smit2400/Solar_Charger/hardware/Solar_Charge_Controller_BOM.csv

Item | References | Qty | Value | Footprint
1 | C1 | 1 | 100UF 50V | CP_Radial_D5.0mm_P2.50mm
2 | C2, C3, C7, C8, C10 | 5 | 100nF | 1206
3 | C4, C9 | 2 | 10UF 50V | CP_Radial_D5.0mm_P2.50mm
4 | C5 | 1 | 10nF | 1206
5 | C6 | 1 | 220nF | 1206
6 | D1, D3, D5 | 3 | PH4148 | 1210
7 | D2, D6 | 2 | 1N4007 | 1210
8 | J1 | 1 | 01x05 | 1X05
9 | J2, J3, J4, J5, J6, J7 | 6 | 01x02 | TE_282837-2
10 | JM1 | 1 | JMP | 1206
11 | JM2, JM3, JM4, JM5, JM6, JM7, JM8, JM9, JM10 | 9 | JMP | DIODE-1N4001
12 | L1, L2, L3 | 3 | LED | LED_5MM
13 | M1, M2, M3 | 3 | TK40E06N1 | TO220V
14 | Q1, Q5 | 2 | MMBT3906 | SOT23-3
15 | Q2, Q4, Q6 | 3 | MMBT3904 | SOT23-3
16 | R1 | 1 | 26KΩ | 1206
17 | R2, R21 | 2 | 1KΩ | 1206
18 | R3, R22, R25, R31 | 4 | 100KΩ | 1206
19 | R4 | 1 | 35KΩ | 1206
20 | R5, R28 | 2 | 100Ω | 1206
21 | R6, R7, R26, R29, R30, R32 | 6 | 10KΩ | 1206
22 | R8, R27 | 2 | 3.3KΩ | 1206
23 | R9, R12 | 2 | 17KΩ | 1206
24 | R10, R16, R20, R40 | 4 | 2KΩ | 1206
25 | R13 | 1 | 21KΩ | 1206
26 | R15 | 1 | 32KΩ | 1206
27 | R33 | 1 | 46KΩ | 1206
28 | R34 | 1 | 15KΩ | 1206
29 | S1 | 1 | RST switch | TACTILE_SWITCH_PTH_6.0MM
30 | U1 | 1 | 78l05 | SOT89R
31 | U2 | 1 | PIC16F676-I/SL | SOIC127P600X175-14N
32 | Z1, Z3 | 2 | 1N4742A | 1210
33 | Z2 | 1 | 1N4742A | DIODE-1N4001
