smit2400/Solar_Charger/hardware/Solar_Charge_Controller.kicad_pcb

## KiCad design hardware/Solar_Charge_Controller.kicad_pcb (2026-11-07)

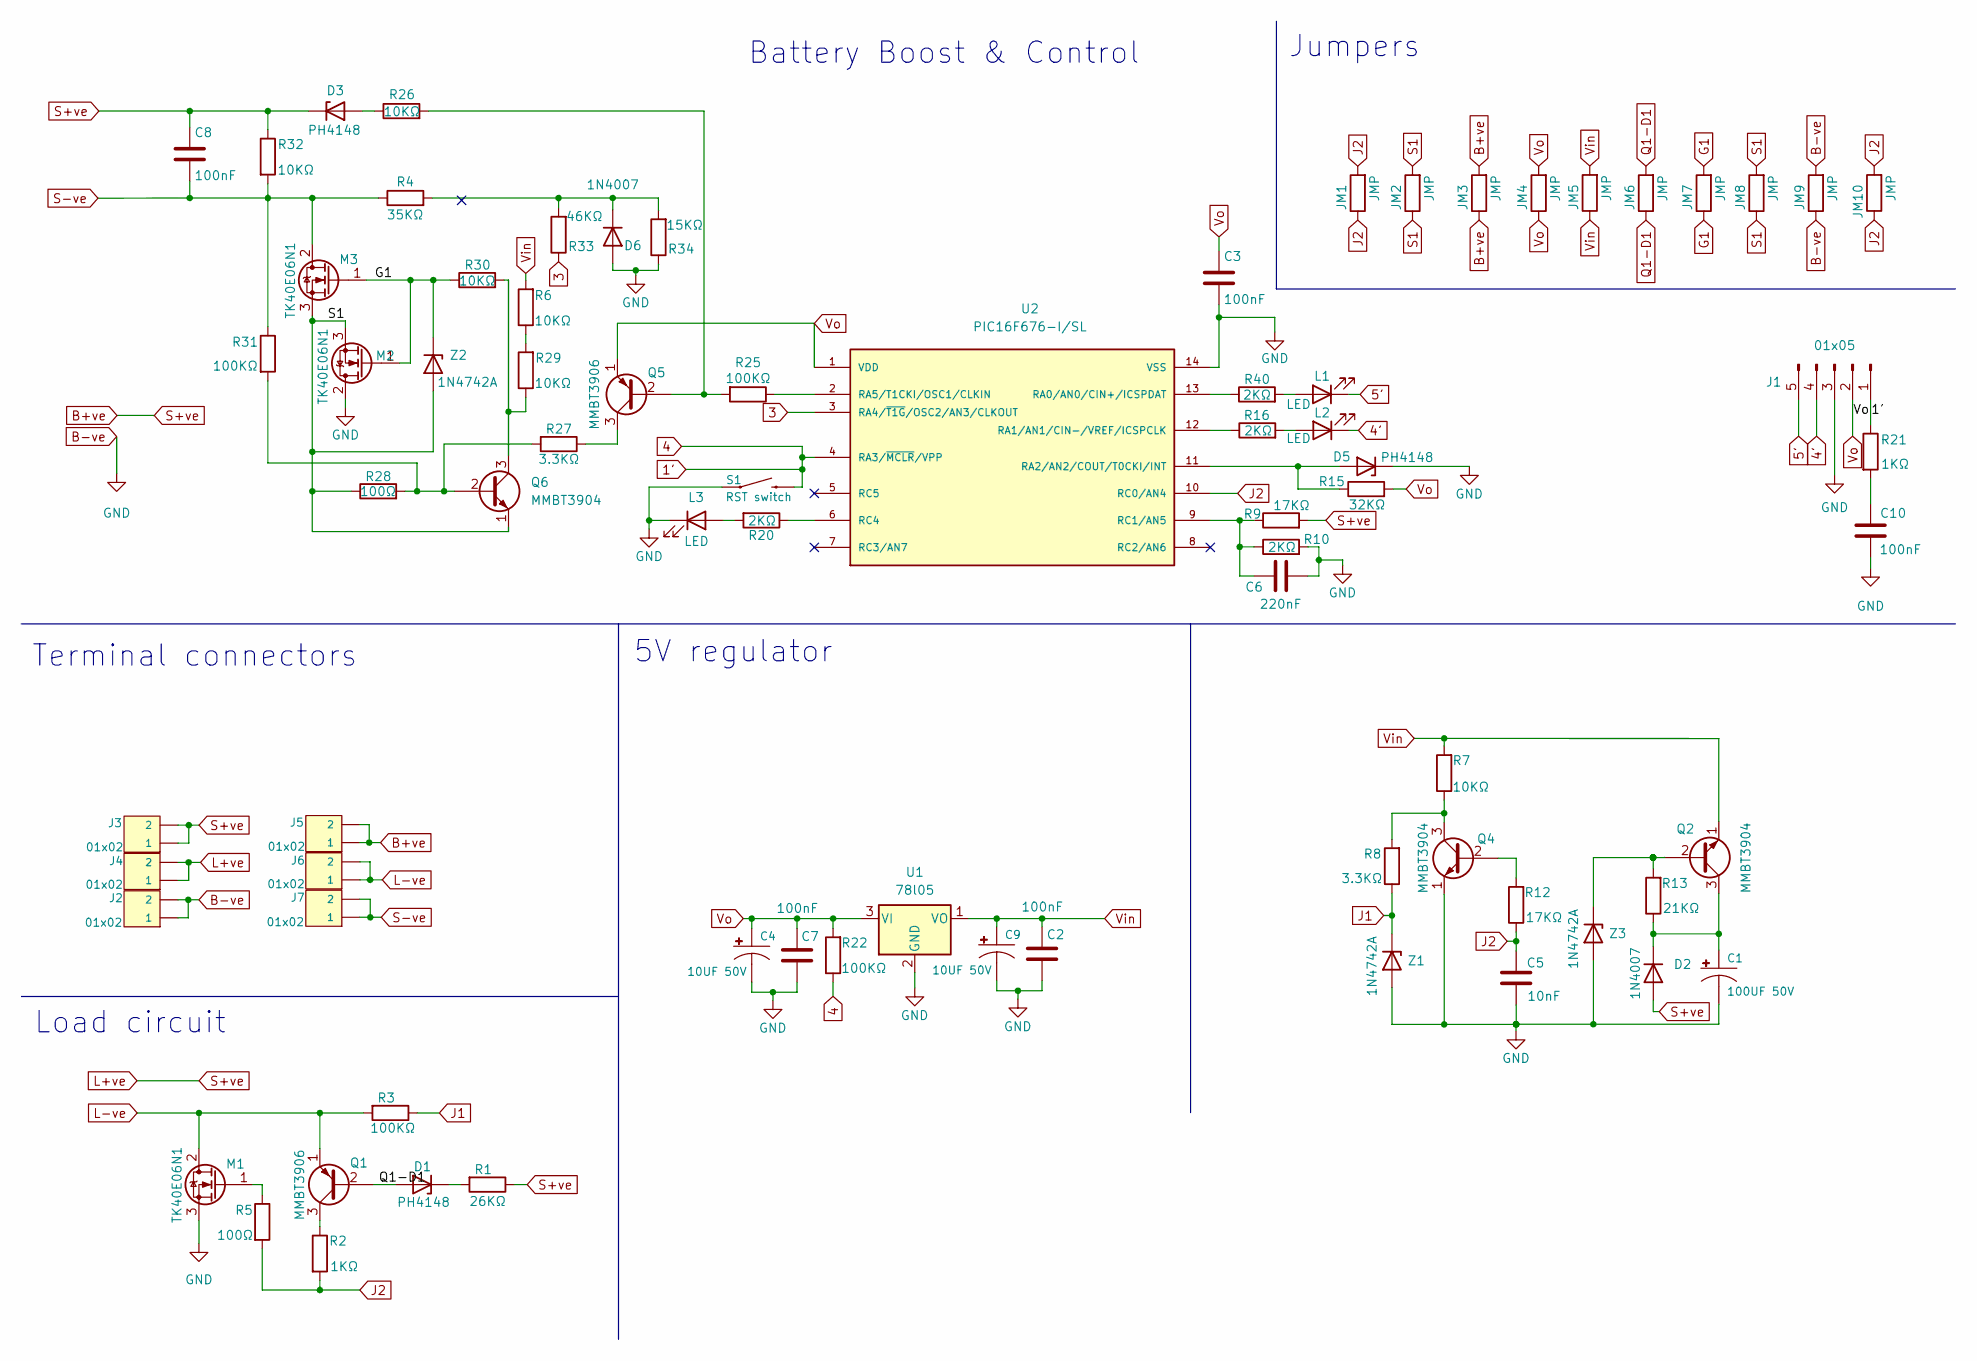
[picture p2: schematic Solar_Charge_Controller.kicad_sch]

Parts:
C1: 100UF 50V; CP_Radial_D5.0mm_P2.50mm
C2, C3, C7, C8, C10: 100nF; 1206
C4, C9: 10UF 50V; CP_Radial_D5.0mm_P2.50mm
C5: 10nF; 1206
C6: 220nF; 1206
D1, D3, D5: PH4148; 1210
D2, D6: 1N4007; 1210
J1: 01x05; 1X05
J2, J3, J4, J5, J6, J7: 01x02; TE_282837-2
JM1: JMP; 1206
JM2, JM3, JM4, JM5, JM6, JM7, JM8, JM9, JM10: JMP; DIODE-1N4001
L1, L2, L3: LED; LED_5MM
M1, M2, M3: TK40E06N1; TO220V
Q1, Q5: MMBT3906; SOT23-3
Q2, Q4, Q6: MMBT3904; SOT23-3
R1: 26KΩ; 1206
R2, R21: 1KΩ; 1206
R3, R22, R25, R31: 100KΩ; 1206
R4: 35KΩ; 1206
R5, R28: 100Ω; 1206
R6, R7, R26, R29, R30, R32: 10KΩ; 1206
R8, R27: 3.3KΩ; 1206
R9, R12: 17KΩ; 1206
R10, R16, R20, R40: 2KΩ; 1206
R13: 21KΩ; 1206
R15: 32KΩ; 1206
R33: 46KΩ; 1206
R34: 15KΩ; 1206
S1: RST switch; TACTILE_SWITCH_PTH_6.0MM
U1: 78l05; SOT89R
U2: PIC16F676-I/SL; SOIC127P600X175-14N
Z1, Z3: 1N4742A; 1210
Z2: 1N4742A; DIODE-1N4001

Connections:
1': J1.1, R21.1, R22.1, S1.3 (2), U2.4 (RA3/~MCLR/VPP)
3: R33.1, U2.3 (RA4/~T1G/OSC2/AN3/CLKOUT)
4': J1.4, L2.1 (K)
5': J1.5, L1.1 (K)
B+ve: C8.1, D2.2 (A), D3.1 (K), J3.1, J3.2, J4.1, J4.2, J5.1, J5.2, JM3.1, JM3.2, R1.1, R9.2, R32.1
B-ve: C2.1, C3.2, C4.2 (-), C6.2, C7.1, C9.2 (-), C10.1, D5.1 (K), D6.2 (A), J1.3, J2.1, J2.2, JM9.1, JM9.2, L3.1 (K), M1.3 (S), M2.2 (D), R10.2, R34.1, S1.1, U1.2 (GND), U2.14 (VSS)
G1: JM7.1, JM7.2, M2.1 (G), M3.1 (G), R30.1, Z2.1 (K)
J1: R3.1, R8.1, Z1.1 (K)
J2: C5.2, JM1.1, JM1.2, JM10.1, JM10.2, R2.2, R5.2, R12.1, U2.10 (RC0/AN4)
L-ve: J6.1, J6.2, M1.2 (D), Q1.1 (E), R3.2
unnamed: C1.1 (+), D2.1 (K), Q2.3 (C), R13.1
unnamed: C1.2 (-), C5.1, Q4.1 (E), Z1.2 (A), Z3.2 (A)
unnamed: C6.1, R9.1, R10.1, U2.9 (RC1/AN5)
unnamed: C10.2, R21.2
unnamed: D1.1 (K), R1.2
unnamed: D3.2 (A), R26.1
unnamed: D5.2 (A), R15.1, U2.11 (RA2/AN2/COUT/T0CKI/INT)
unnamed: D6.1 (K), R4.2, R33.2, R34.2
unnamed: L1.2 (A), R40.2
unnamed: L2.2 (A), R16.2
unnamed: L3.2 (A), R20.2
unnamed: M1.1 (G), R5.1
unnamed: Q1.3 (C), R2.1
unnamed: Q2.2 (B), R13.2, Z3.1 (K)
unnamed: Q4.2 (B), R12.2
unnamed: Q4.3 (C), R7.1, R8.2
unnamed: Q5.2 (B), R25.2, R26.2
unnamed: Q5.3 (C), R27.1
unnamed: Q6.2 (B), R27.2, R28.2, R31.2
unnamed: Q6.3 (C), R29.1, R30.2
unnamed: R16.1, U2.12 (RA1/AN1/CIN-/VREF/ICSPCLK)
unnamed: R20.1, U2.6 (RC4)
unnamed: R25.1, U2.2 (RA5/T1CKI/OSC1/CLKIN)
unnamed: R6.1, R29.2
unnamed: R40.1, U2.13 (RA0/AN0/CIN+/ICSPDAT)
Q1-D1: D1.2 (A), JM6.1, JM6.2, Q1.2 (B)
S1: JM2.1, JM2.2, JM8.1, JM8.2, M2.3 (S), M3.3 (S), Q6.1 (E), R28.1, Z2.2 (A)
S-ve: C8.2, J7.1, J7.2, M3.2 (D), R4.1, R31.1, R32.2
Vin: C2.2, C9.1 (+), JM5.1, JM5.2, Q2.1 (E), R6.2, R7.2, U1.1 (VO)
Vo: C3.1, C4.1 (+), C7.2, J1.2, JM4.1, JM4.2, Q5.1 (E), R15.2, R22.2, U1.3 (VI), U2.1 (VDD)

Notes on the sheet:
Load circuit
Battery Boost & Control
5V regulator
Jumpers
Terminal connectors

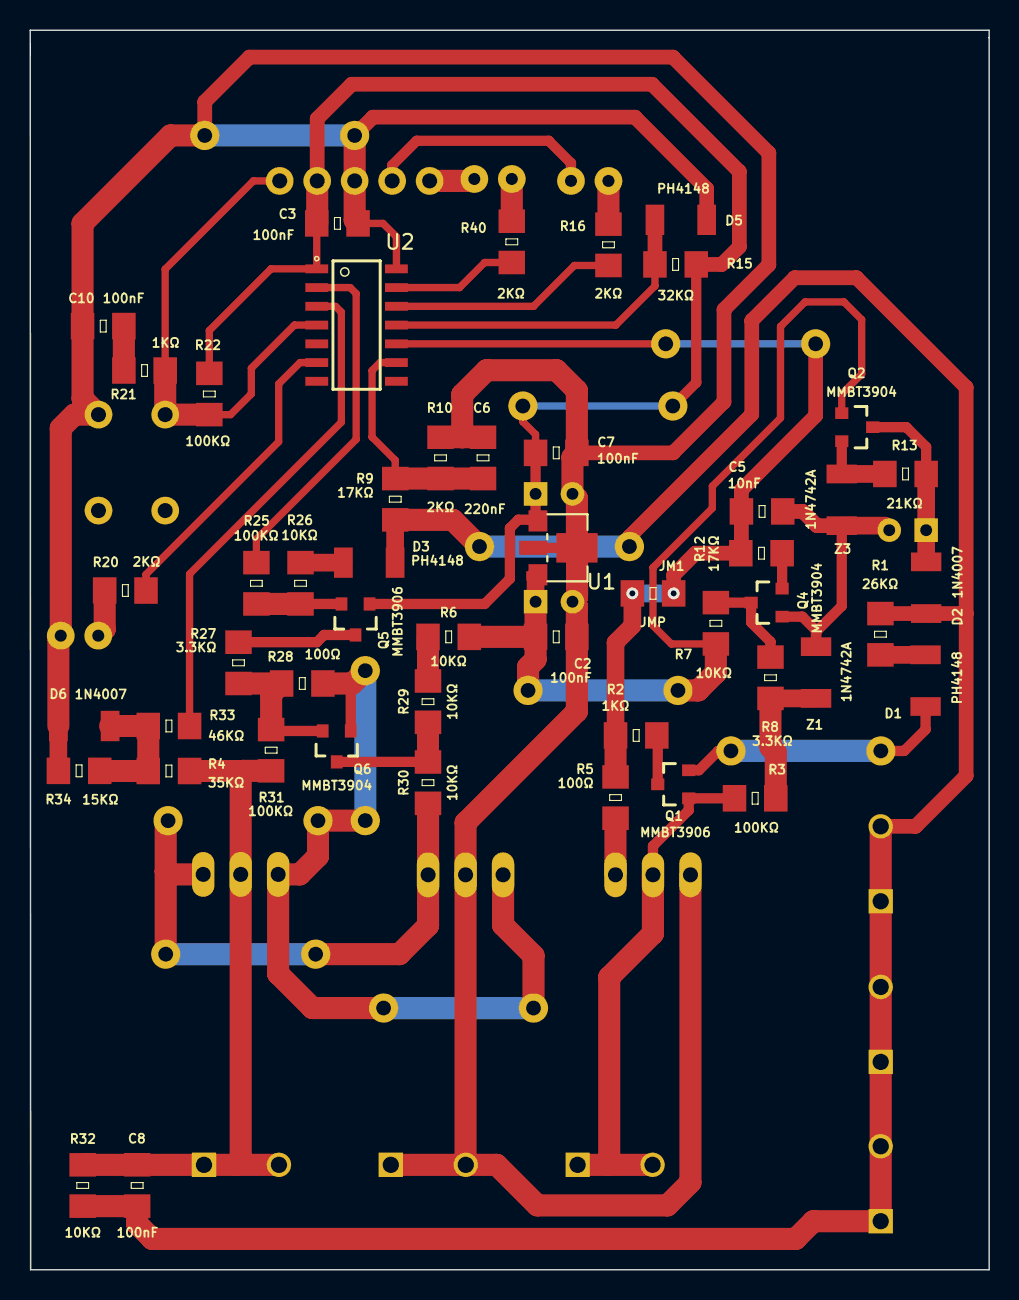
[picture p3: board Solar_Charge_Controller.kicad_pcb from above]

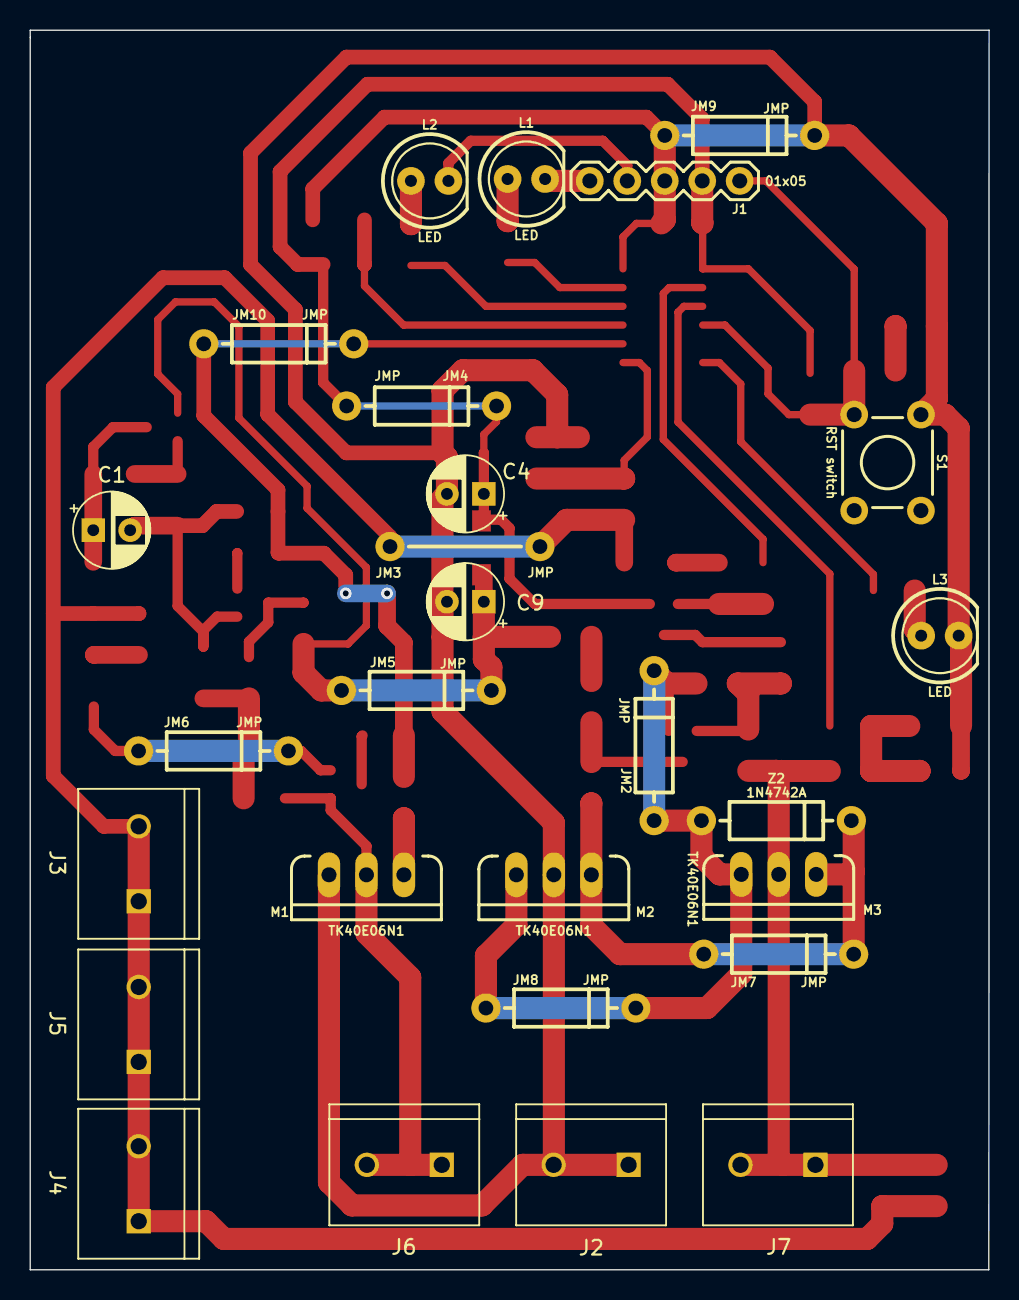
[picture p4: board Solar_Charge_Controller.kicad_pcb from below]

Board: 2 copper layers, 65.0 x 84.0 mm, 77 parts (27 on the bottom side), 40 nets.
